mr-sandman-labs/flight-computer/README.md

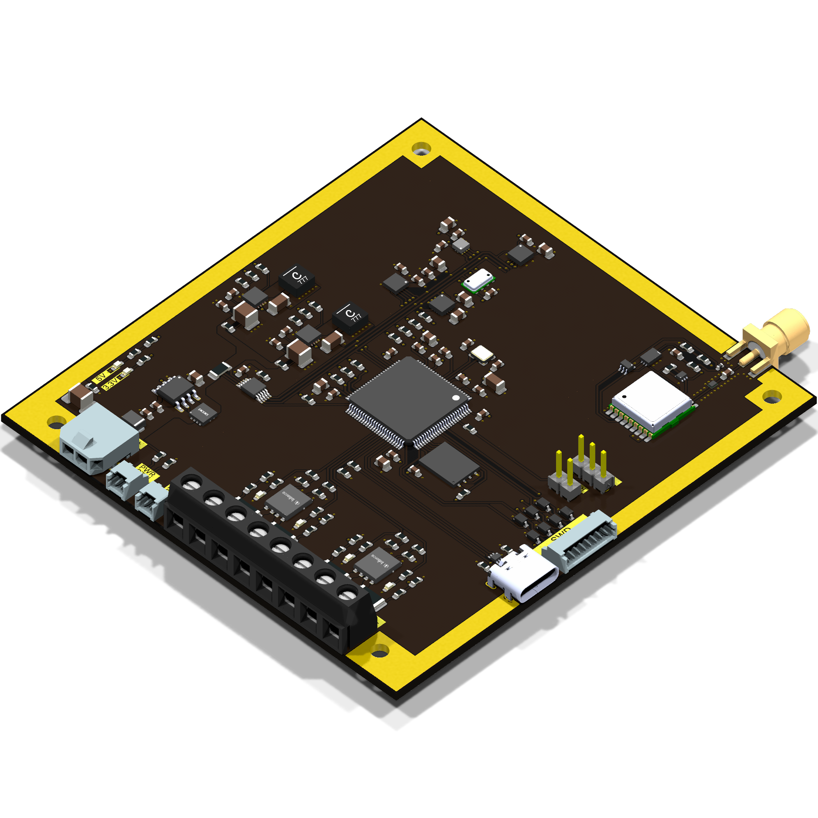
[picture p1: development/render/isometric_top.png]

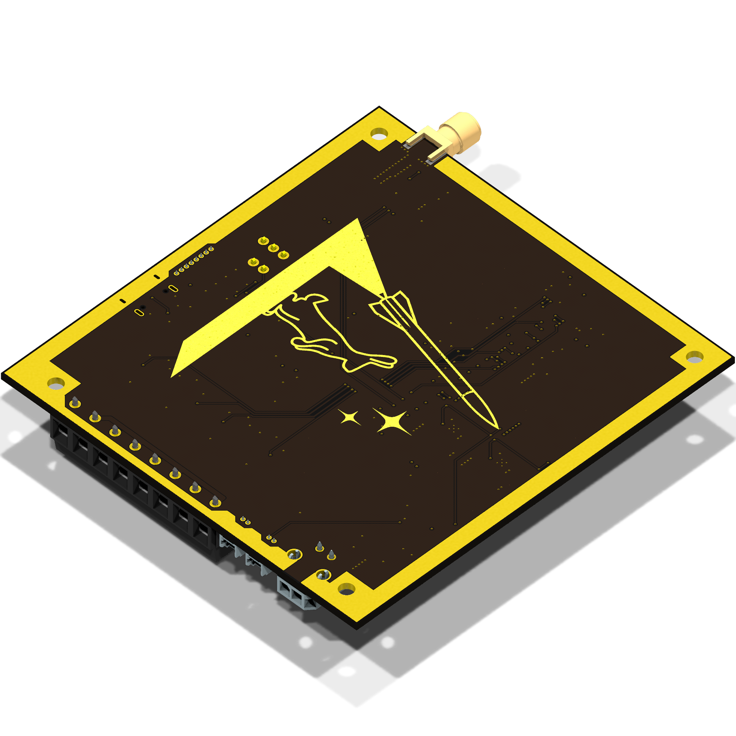
[picture p2: development/render/isometric_bottom.png]
