mr-sandman-labs/flight-computer/development/schematic.pdf

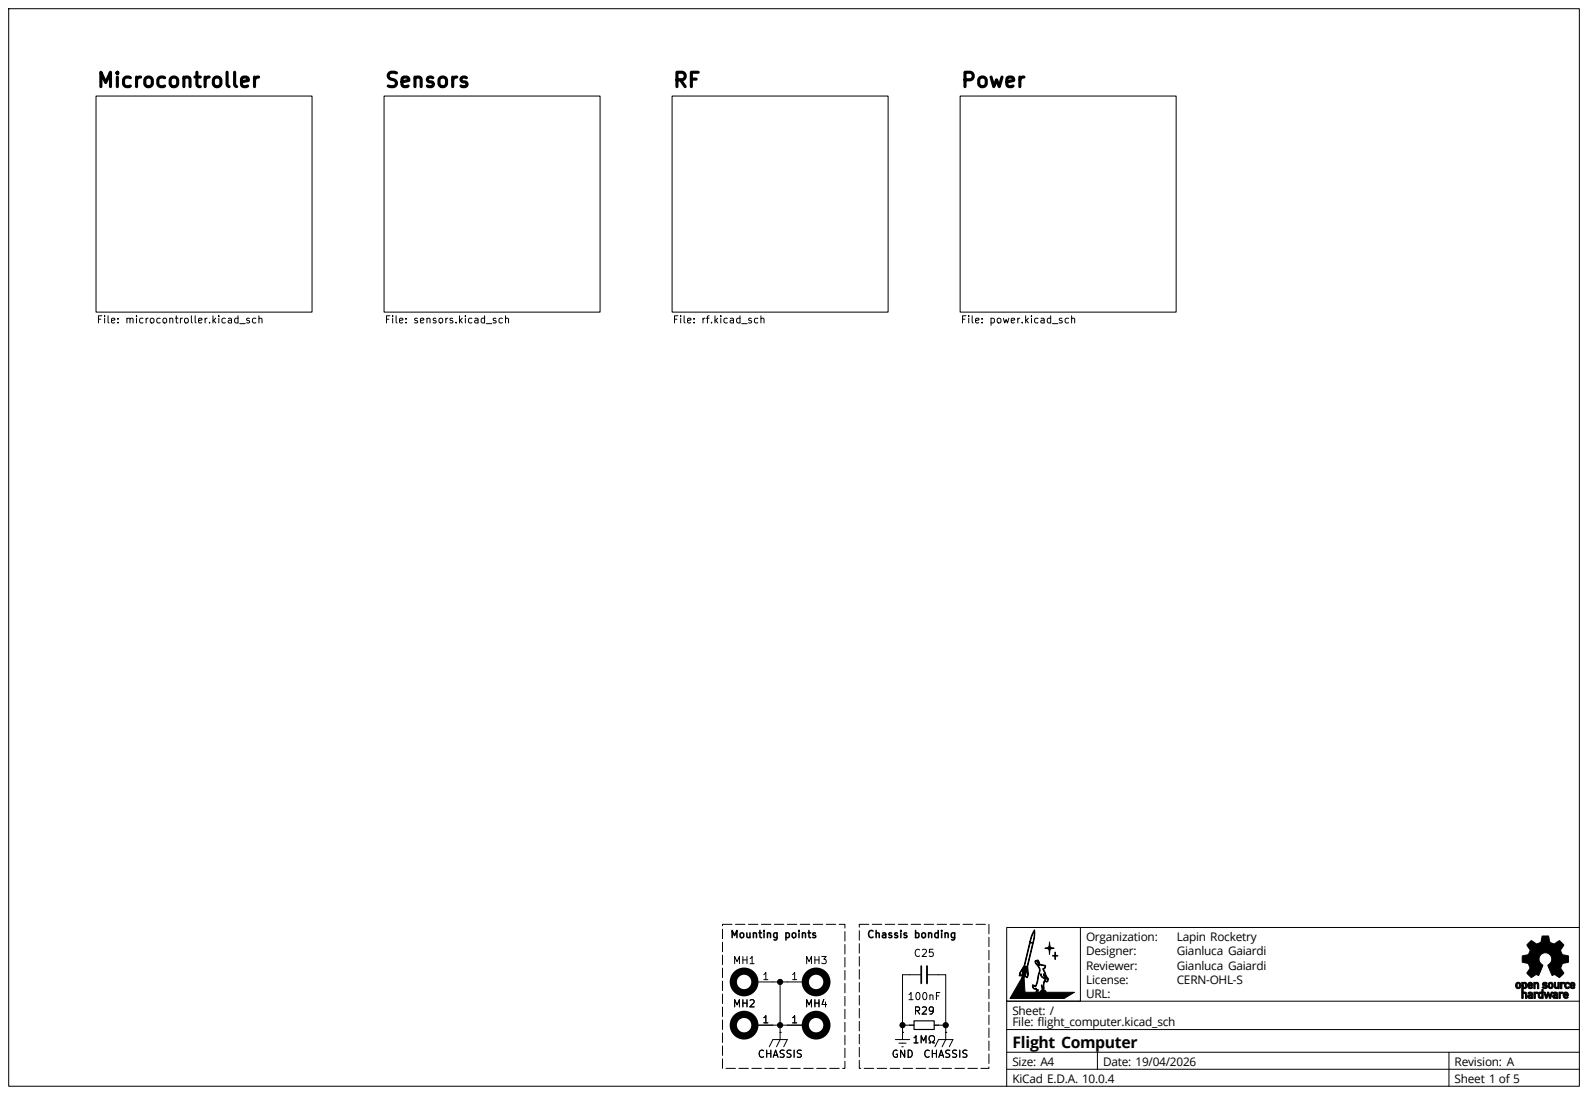
[picture p3: page 1]

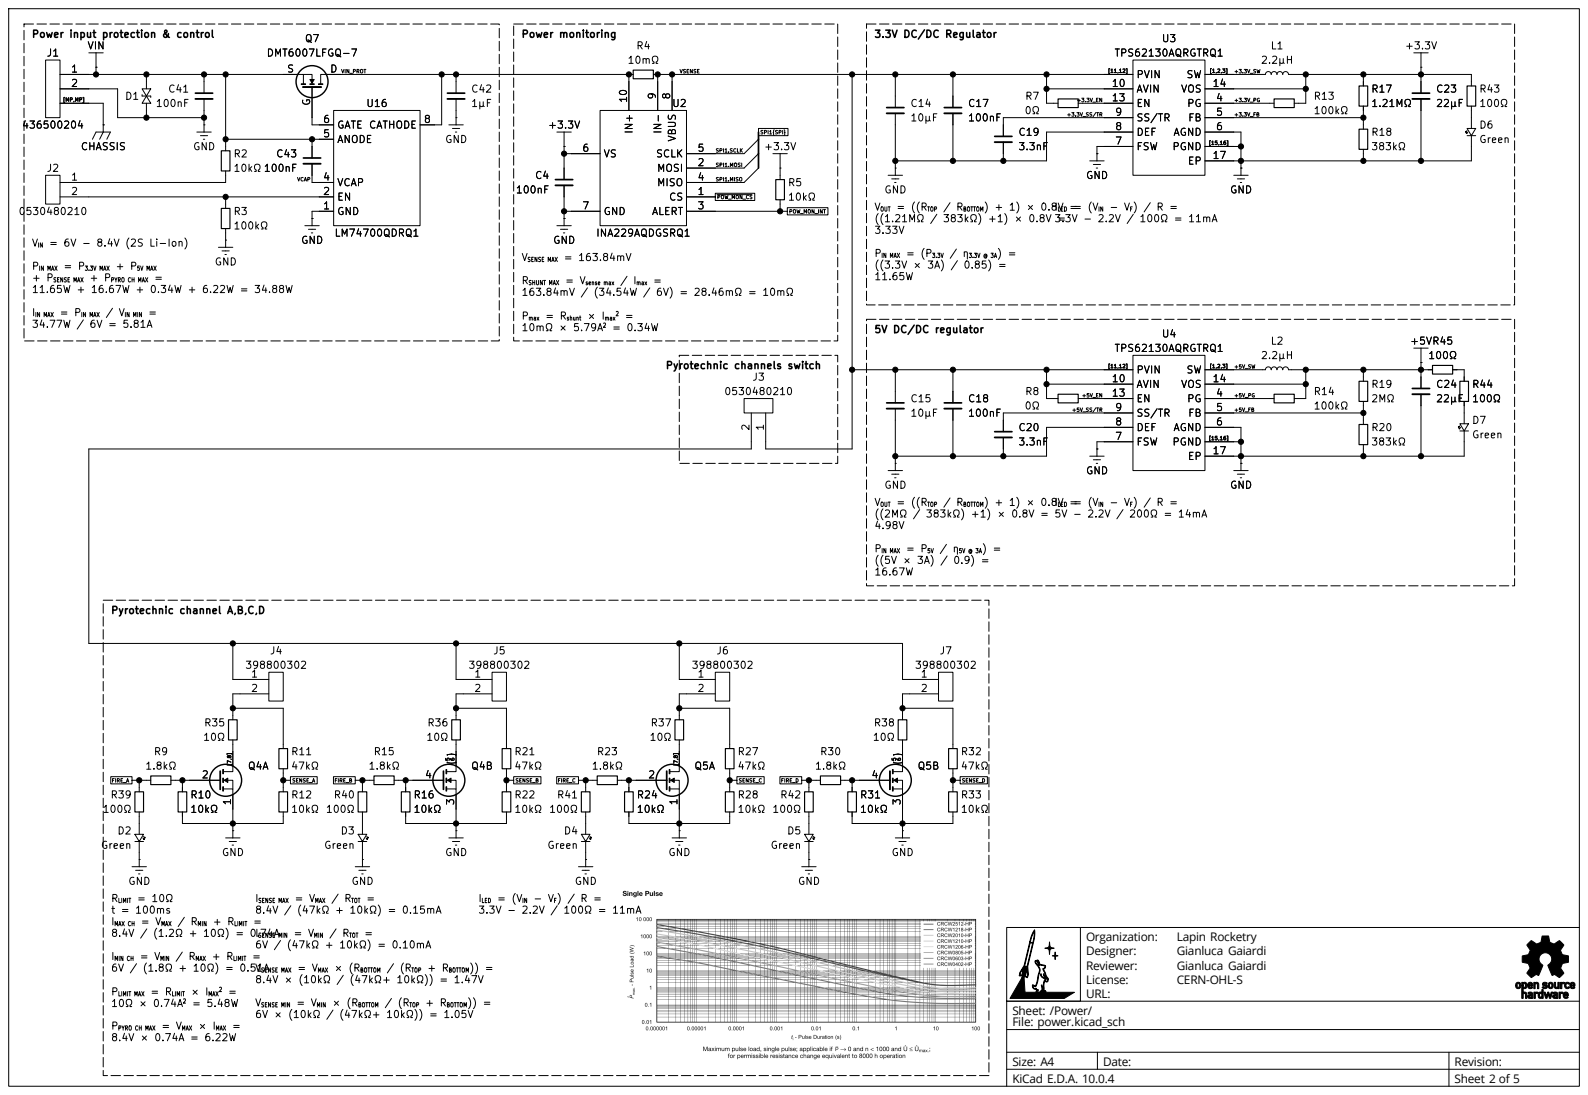
[picture p4: page 2]

VIN = 6V - 8.4V (2S Li-Ion) PIN MAX = P3.3V MAX + P5V MAX + PSENSE MAX + PPYRO CH MAX =

VSENSE MAX = 163.84mV RSHUNT MAX = Vsense max / Imax =

IIN MAX = PIN MAX / VIN MIN =

Pyrotechnic channels switch RLIMIT = 10Ω

ISENSE MAX = VMAX / RTOT =

ISENSE MIN = VMIN / RTOT =

IMIN CH = VMIN / RMAX + RLIMIT =
6V / (1.8Ω + 10Ω) = 0.51A PLIMIT MAX = RLIMIT × IMAX2 =

Sheet: /Power/URL: License: Reviewer: Designer:

VSENSE MAX = VMAX × (RBOTTOM / (RTOP + RBOTTOM)) =

VSENSE MIN = VMIN × (RBOTTOM / (RTOP + RBOTTOM)) =

PPYRO CH MAX = VMAX × IMAX =

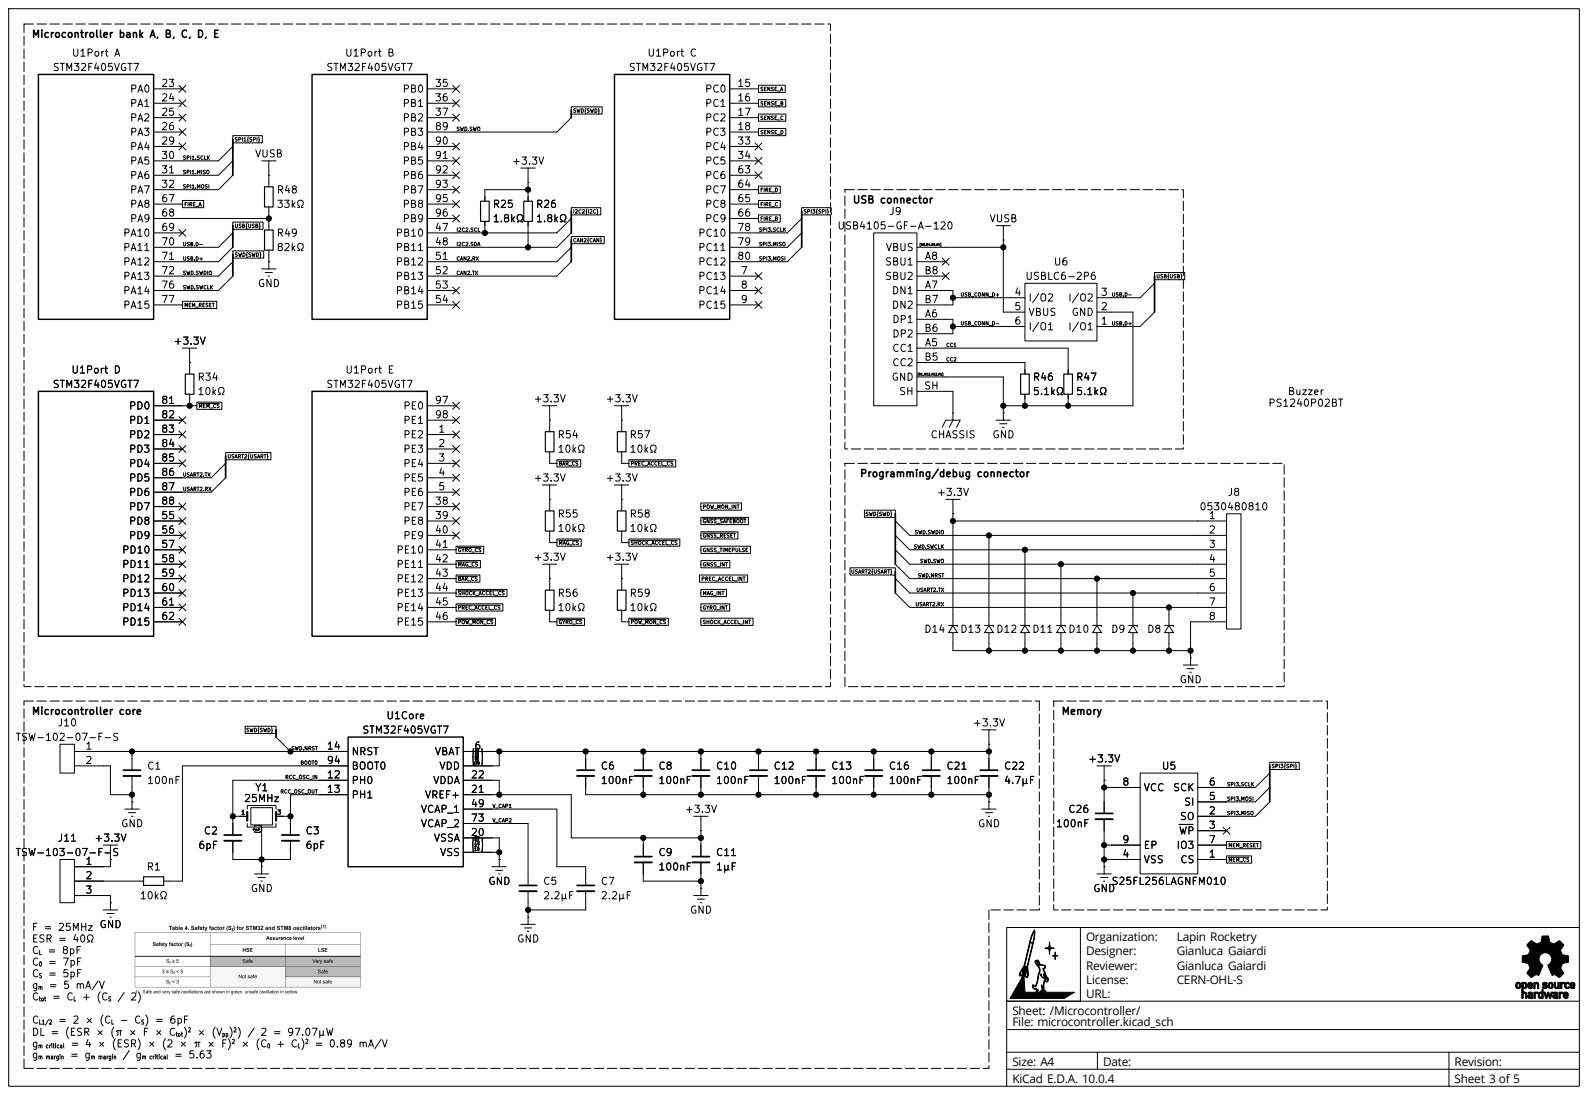
[picture p5: page 3]

Programming/debug connector F = 25MHz ESR = 40Ω

SWD.NRST SWD.SWDIO

2 = 0.89 mA/V gm margin = gm margin / gm critical = 5.63 Microcontroller core

CL = 8pF C0 = 7pF CS = 5pF gm = 5 mA/V Ctot = CL + (CS / 2) CL1/2 = 2 × (CL - CS) = 6pF DL = (ESR × (π × F × Ctot)

Sheet: /Microcontroller/ URL: License: Reviewer: Designer:

gm critical = 4 × (ESR) × (2 × π × F)2 × (C0 + CL)

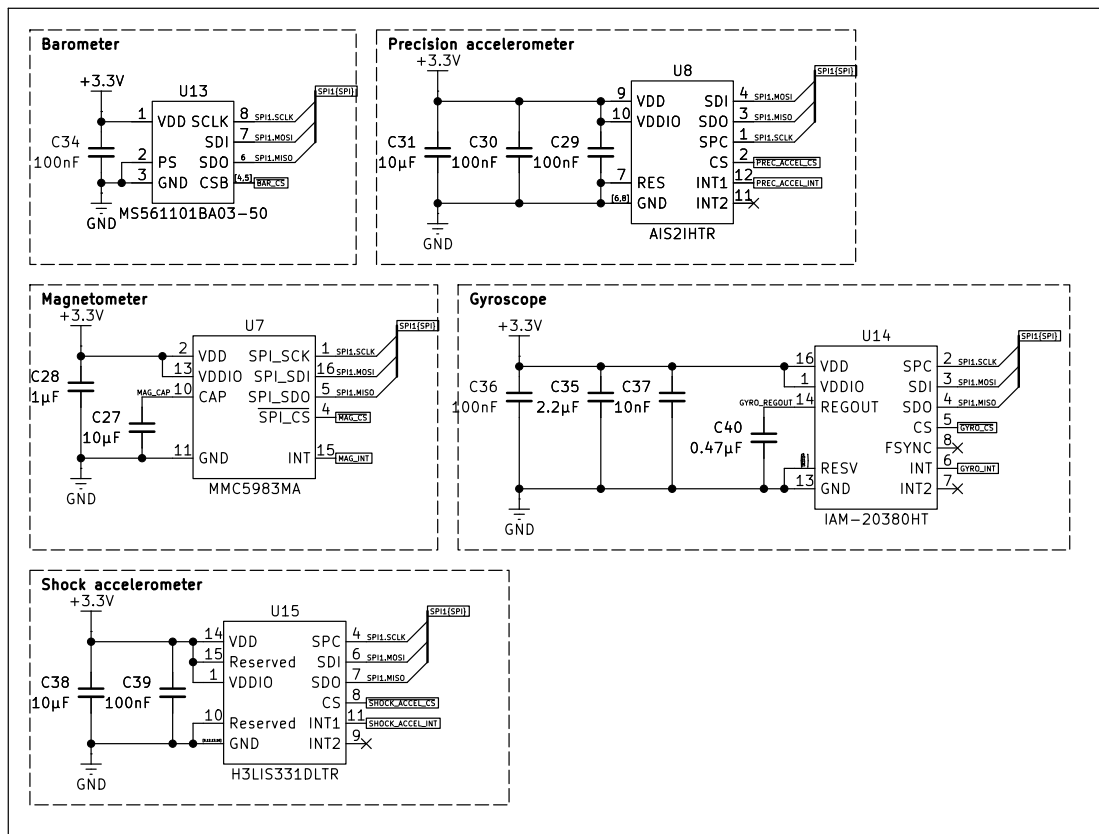
[picture p6: page 4]

Sheet: /Sensors/ URL: License: Reviewer: Designer:

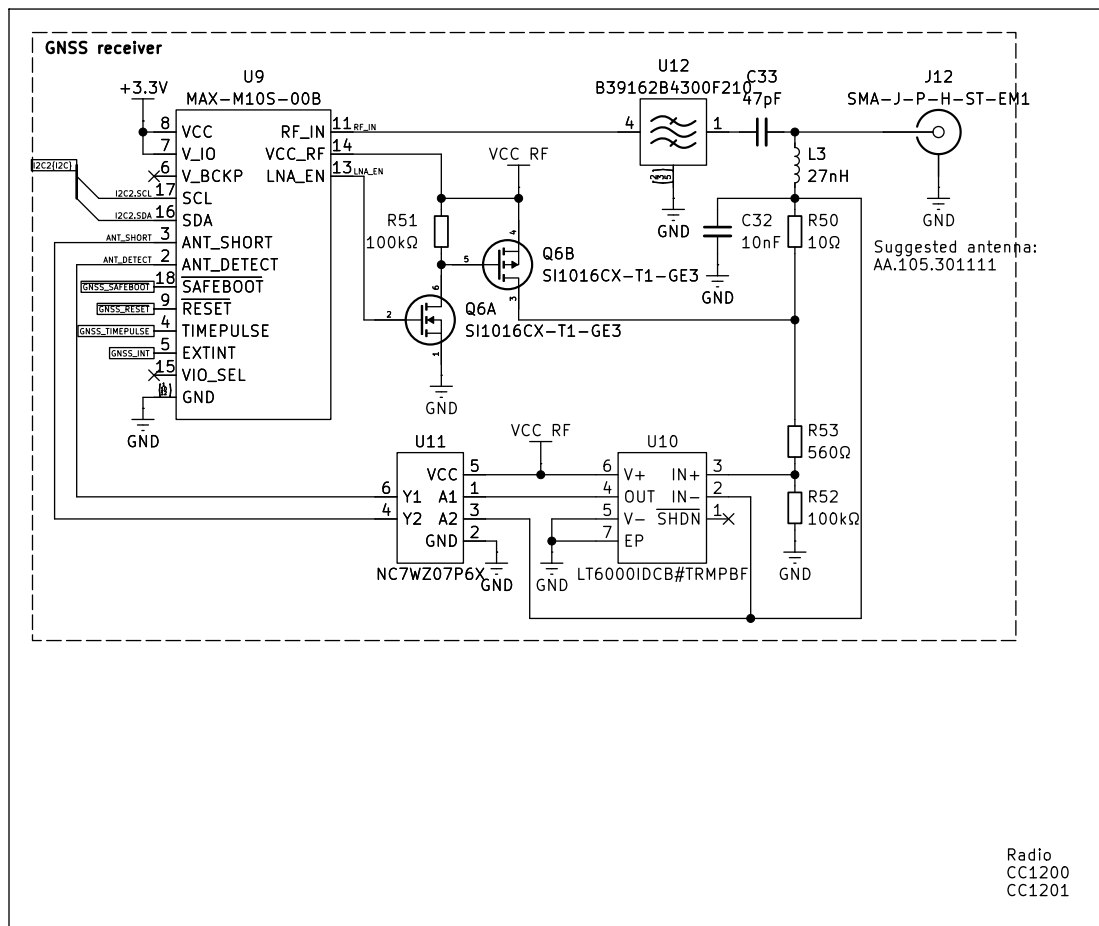
[picture p7: page 5]
