mr-sandman-labs/flight-computer/flight_computer.kicad_pcb

## KiCad design flight_computer.kicad_pcb (2026-06-22)

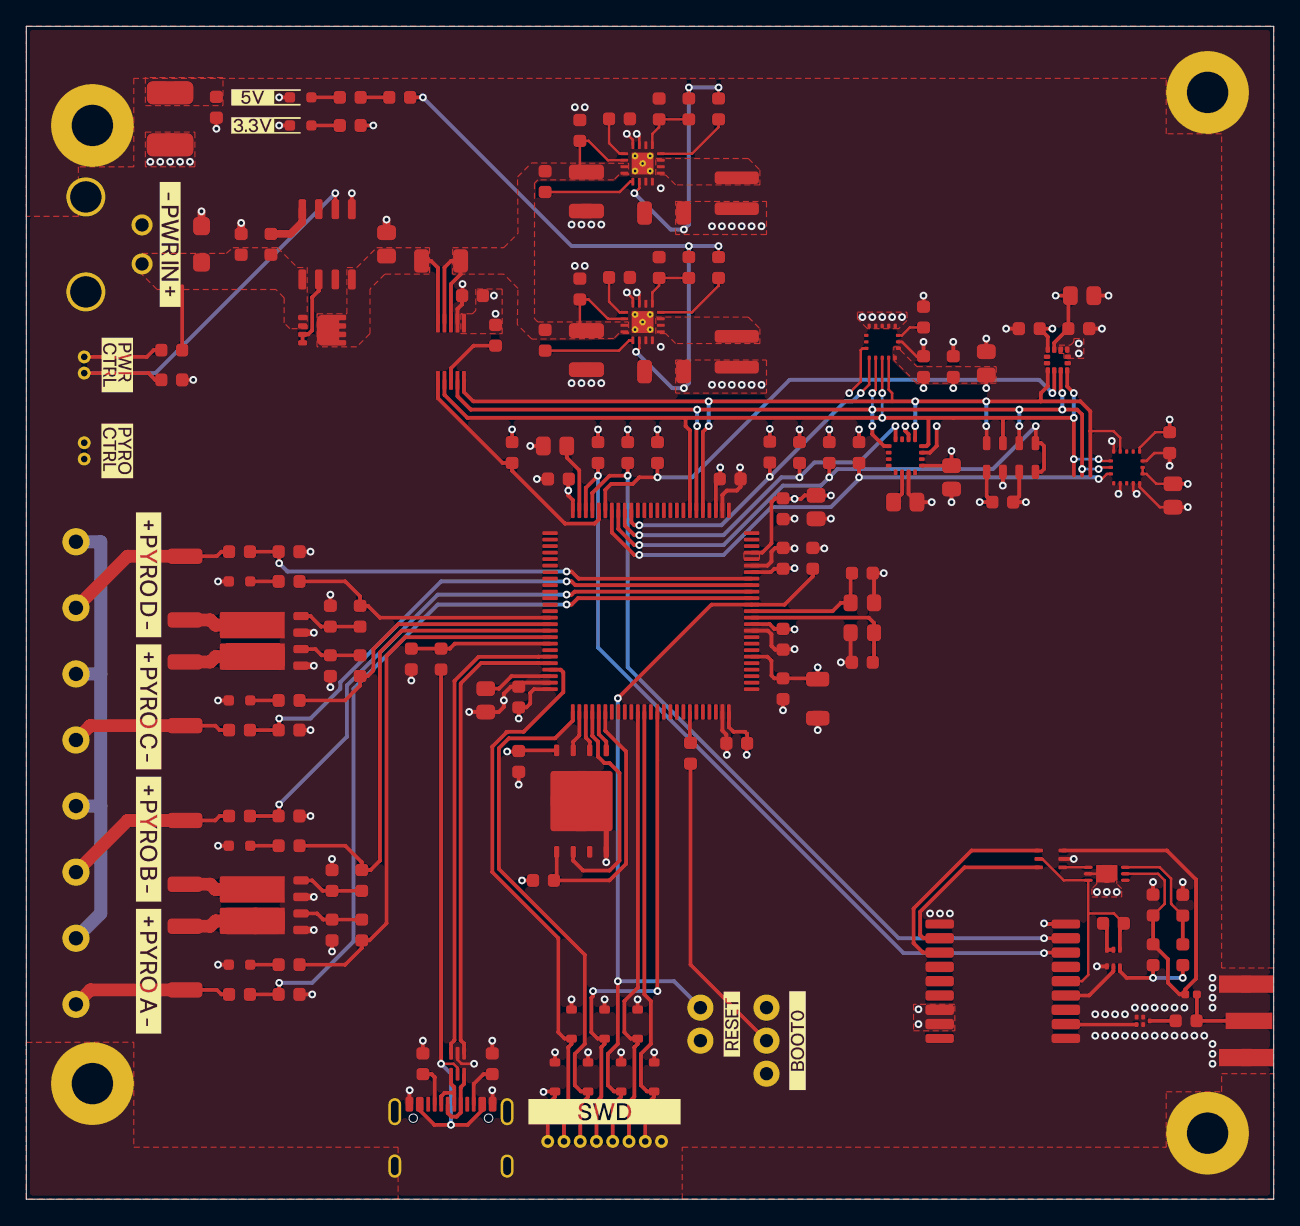
[picture p16: board flight_computer.kicad_pcb from above]

Board: 4 copper layers, 95.9 x 90.2 mm, 167 parts (0 on the bottom side), 100 nets.

Parts:
C1, C4, C6, C8, C9, C10, C12, C13, C16, C17, C18, C21, C26, C29, C30, C34, C36, C39, C41, C43: 100nF; C_0603_Density_Nominal
C2, C3: 6pF; C_0603_Density_Nominal
C5, C7, C35: 2.2μF; C_0805_Density_Nominal
C11, C28, C42: 1μF; C_0805_Density_Nominal
C14, C15: 10μF; C_1210_Density_Nominal
C19, C20: 3.3nF; C_0603_Density_Nominal
C22: 4.7μF; C_1206_Density_Nominal
C23, C24: 22μF; C_1206_Density_Nominal
C25: 100nF; C_1812_Density_Nominal
C27, C31, C38: 10μF; C_0805_Density_Nominal
C32, C37: 10nF; C_0603_Density_Nominal
C33: 47pF; C_0603_Density_Nominal
C40: 0.47µF; C_0603_Density_Nominal
D1: SZSMF4L17CAT3G
D2, D3, D4, D5, D6, D7: Green; SML-D12P8WT86C
D8, D9, D10, D11, D12, D13, D14: SZESD7351HT1G
J1: 436500204
J2, J3: 0530480210
J4, J5, J6, J7: 398800302
J8: 0530480810
J9: USB4105-GF-A-120
J10: TSW-102-07-F-S
J11: TSW-103-07-F-S
J12: SMA-J-P-H-ST-EM1
L1, L2: 2.2μH; XGL4020-222MEC
L3: 27nH; L_0402_Density_Nominal
MH1, MH2, MH3, MH4: M3
Q4, Q5: IPG20N04S4L08ATMA1
Q6: SI1016CX-T1-GE3
Q7: DMT6007LFGQ-7
R1, R2, R5, R10, R12, R16, R22, R24, R28, R31, R33, R34, R54, R55, R56, R57, R58, R59: 10kΩ; R_0603_Density_Nominal
R3, R13, R14, R51, R52: 100kΩ; R_0603_Density_Nominal
R4: 10mΩ; R_1206_Density_Nominal
R7, R8: 0Ω; R_0603_Density_Nominal
R9, R15, R23, R25, R26, R30: 1.8kΩ; R_0603_Density_Nominal
R11, R21, R27, R32: 47kΩ; R_0603_Density_Nominal
R17: 1.21MΩ; R_0603_Density_Nominal
R18, R20: 383kΩ; R_0603_Density_Nominal
R19: 2MΩ; R_0603_Density_Nominal
R29: 1MΩ; R_0603_Density_Nominal
R35, R36, R37, R38: 10Ω; R_2010_Density_Nominal
R39, R40, R41, R42, R43, R44, R45: 100Ω; R_0603_Density_Nominal
R46, R47: 5.1kΩ; R_0603_Density_Nominal
R48: 33kΩ; R_0603_Density_Nominal
R49: 82kΩ; R_0603_Density_Nominal
R50: 10Ω; R_0603_Density_Nominal
R53: 560Ω; R_0603_Density_Nominal
U1: STM32F405VGT7
U2: INA229AQDGSRQ1
U3, U4: TPS62130AQRGTRQ1
U5: S25FL256LAGNFM010
U6: USBLC6-2P6
U7: MMC5983MA
U8: AIS2IHTR
U9: MAX-M10S-00B
U10: LT6000IDCB#TRMPBF
U11: NC7WZ07P6X
U12: B39162B4300F210
U13: MS561101BA03-50
U14: IAM-20380HT
U15: H3LIS331DLTR
U16: LM74700QDRQ1
Y1: 25MHz; ECS-250-8-33Q-RES-TR
kibuzzard-6A2D8A19: G***; kibuzzard-6A2D8A19
kibuzzard-6A2D86D8: G***; kibuzzard-6A2D86D8
kibuzzard-6A2D86DB: G***; kibuzzard-6A2D86DB
kibuzzard-6A2D88AE: G***; kibuzzard-6A2D88AE
kibuzzard-6A2D88CA: G***; kibuzzard-6A2D88CA
kibuzzard-6A2D88D0: G***; kibuzzard-6A2D88D0
kibuzzard-6A2D88D5: G***; kibuzzard-6A2D88D5
kibuzzard-6A2D89E8: G***; kibuzzard-6A2D89E8
kibuzzard-6A2D888E: G***; kibuzzard-6A2D888E
kibuzzard-6A2D8804: G***; kibuzzard-6A2D8804
kibuzzard-6A2D8820: G***; kibuzzard-6A2D8820
kibuzzard-6A2DBB13: G***; kibuzzard-6A2DBB13

Connections:
+3.3V: C4.1, C6.1, C8.1, C9.1, C10.1, C11.1, C12.1, C13.1, C16.1, C21.1, C22.1, C23.1, C26.1, C28.1, C29.1, C30.1, C31.1, C34.1, C35.1, C36.1, C37.1, C38.1, C39.1, D14.1, J8.1, J11.1, L1.2, R5.1, R13.2, R17.1, R25.1, R26.1, R34.1, R43.1, R54.1, R55.1, R56.1, R57.1, R58.1, R59.1, U1.6 (VBAT), U1.11 (VDD), U1.19 (VDD), U1.21 (VREF+), U1.22 (VDDA), U1.28 (VDD), U1.50 (VDD), U1.75 (VDD), U1.100 (VDD), U2.6 (VS), U3.14 (VOS), U5.8 (VCC), U7.2 (VDD), U7.13 (VDDIO), U8.9 (VDD), U8.10 (VDDIO), U9.7 (V_IO), U9.8 (VCC), U13.1 (VDD), U14.1 (VDDIO), U14.16 (VDD), U15.1 (VDDIO), U15.14 (VDD), U15.15 (Reserved)
+5V: C24.1, L2.2, R14.2, R19.1, R45.1, U4.14 (VOS)
/Microcontroller/BOOT0: R1.2, U1.94 (BOOT0)
/Microcontroller/CC1: J9.A5 (CC1), R47.1
/Microcontroller/CC2: J9.B5 (CC2), R46.1
/Microcontroller/RCC_OSC_IN: C2.1, U1.12 (PH0), Y1.1
/Microcontroller/RCC_OSC_OUT: C3.1, U1.13 (PH1), Y1.3
/Microcontroller/USB_CONN_D+: J9.A7 (DN1), J9.B7 (DN2), U6.4 (I/O2)
/Microcontroller/USB_CONN_D-: J9.A6 (DP1), J9.B6 (DP2), U6.6 (I/O1)
/Microcontroller/V_CAP1: C7.1, U1.49 (VCAP_1)
/Microcontroller/V_CAP2: C5.1, U1.73 (VCAP_2)
/Power/+3.3V_EN: R7.2, U3.13 (EN)
/Power/+3.3V_FB: R17.2, R18.1, U3.5 (FB)
/Power/+3.3V_PG: R13.1, U3.4 (PG)
/Power/+3.3V_SS/TR: C19.1, U3.9 (SS/TR)
/Power/+3.3V_SW: L1.1, U3.1 (SW), U3.2 (SW), U3.3 (SW)
/Power/+5V_EN: R8.2, U4.13 (EN)
/Power/+5V_FB: R19.2, R20.1, U4.5 (FB)
/Power/+5V_PG: R14.1, U4.4 (PG)
/Power/+5V_SS/TR: C20.1, U4.9 (SS/TR)
/Power/+5V_SW: L2.1, U4.1 (SW), U4.2 (SW), U4.3 (SW)
/Power/VCAP: C43.2, U16.4 (VCAP)
/Power/VIN_PROT: C42.1, Q7.D, R4.1, U2.10 (IN+), U16.8 (CATHODE)
/Power/VSENSE: C14.1, C15.1, C17.1, C18.1, J3.1, R4.2, R7.1, R8.1, U2.8 (VBUS), U2.9 (IN-), U3.10 (AVIN), U3.11 (PVIN), U3.12 (PVIN), U4.10 (AVIN), U4.11 (PVIN), U4.12 (PVIN)
/RF/ANT_DETECT: U9.2 (ANT_DETECT), U11.6 (Y1)
/RF/ANT_SHORT: U9.3 (ANT_SHORT), U11.4 (Y2)
/RF/LNA_EN: Q6.2 (G), U9.13 (LNA_EN)
/RF/RF_IN: U9.11 (RF_IN), U12.4 (Output)
/Sensors/GYRO_REGOUT: C40.1, U14.14 (REGOUT)
/Sensors/MAG_CAP: C27.1, U7.10 (CAP)
CHASSIS: C25.2, J1.MP, J9.SH, MH1.1 (MH_1), MH2.1 (MH_1), MH3.1 (MH_1), MH4.1 (MH_1), R29.2
FIRE_A: R9.1, R39.1, U1.67 (PA8)
FIRE_B: R15.1, R40.1, U1.66 (PC9)
FIRE_C: R23.1, R41.1, U1.65 (PC8)
FIRE_D: R30.1, R42.1, U1.64 (PC7)
GND: C1.2, C2.2, C3.2, C4.2, C5.2, C6.2, C7.2, C8.2, C9.2, C10.2, C11.2, C12.2, C13.2, C14.2, C15.2, C16.2, C17.2, C18.2, C19.2, C20.2, C21.2, C22.2, C23.2, C24.2, C25.1, C26.2, C27.2, C28.2, C29.2, C30.2, C31.2, C32.2, C34.2, C35.2, C36.2, C37.2, C38.2, C39.2, C40.2, C41.2, C42.2, D1.2, D2.1, D3.1, D4.1, D5.1, D6.1, D7.1, D8.2, D9.2, D10.2, D11.2, D12.2, D13.2, D14.2, J1.2, J8.8, J9.A1 (GND), J9.A12 (GND), J9.B1 (GND), J9.B12 (GND), J10.2, J11.3, J12.2, Q4.1 (S), Q4.3 (S), Q5.1 (S), Q5.3 (S), Q6.1 (S), R3.2, R10.2, R12.2, R16.2, R18.2, R20.2, R22.2, R24.2, R28.2, R29.1, R31.2, R33.2, R46.2, R47.2, R49.2, R52.2, U1.10 (VSS), U1.20 (VSSA), U1.27 (VSS), U1.74 (VSS), U1.99 (VSS), U2.7 (GND), U3.6 (AGND), U3.7 (FSW), U3.8 (DEF), U3.15 (PGND), U3.16 (PGND), U3.17 (EP), U4.6 (AGND), U4.7 (FSW), U4.8 (DEF), U4.15 (PGND), U4.16 (PGND), U4.17 (EP), U5.4 (VSS), U5.9 (EP), U6.2 (GND), U7.11 (GND), U8.6 (GND), U8.7 (RES), U8.8 (GND), U9.1 (GND), U9.10 (GND), U9.12 (GND), U10.5 (V-), U10.7 (EP), U11.2 (GND), U12.2 (GND), U12.3 (GND), U12.5 (GND), U13.2 (PS), U13.3 (GND), U14.9 (RESV), U14.10 (RESV), U14.11 (RESV), U14.12 (RESV), U14.13 (GND), U14.15 (RESV), U15.5 (GND), U15.10 (Reserved), U15.12 (GND), U15.13 (GND), U15.16 (GND), U16.1 (GND), Y1.2 (GND), Y1.4 (GND)
I2C2.SCL: R25.2, U1.47 (PB10), U9.17 (SCL)
I2C2.SDA: R26.2, U1.48 (PB11), U9.16 (SDA)
MEM_RESET: U1.77 (PA15), U5.7 (IO3)
unnamed: C33.2, J12.1, L3.1
unnamed: D2.2, R39.2
unnamed: D3.2, R40.2
unnamed: D4.2, R41.2
unnamed: D5.2, R42.2
unnamed: D6.2, R43.2
unnamed: D7.2, R44.2
unnamed: J2.1, R2.2
unnamed: J3.2, J4.1, J5.1, J6.1, J7.1
unnamed: J4.2, R11.1, R35.1
unnamed: J5.2, R21.1, R36.1
unnamed: J6.2, R27.1, R37.1
unnamed: J7.2, R32.1, R38.1
unnamed: J11.2, R1.1
unnamed: Q4.7 (D), Q4.8 (D), R35.2
unnamed: Q4.2 (G), R9.2, R10.1
unnamed: Q4.5 (D), Q4.6 (D), R36.2
unnamed: Q4.4 (G), R15.2, R16.1
unnamed: Q5.7 (D), Q5.8 (D), R37.2
unnamed: Q5.2 (G), R23.2, R24.1
unnamed: Q5.5 (D), Q5.6 (D), R38.2
unnamed: Q5.4 (G), R30.2, R31.1
unnamed: Q6.5 (G), Q6.6 (D), R51.1
unnamed: Q6.3 (D), R50.2, R53.1
unnamed: R44.1, R45.2
unnamed: R48.2, R49.1, U1.68 (PA9)
unnamed: R52.1, R53.2, U10.3 (IN+)
unnamed: C32.1, L3.2, R50.1, U10.2 (IN-), U11.3 (A2)
unnamed: U10.4 (OUT), U11.1 (A1)
unnamed: C33.1, U12.1 (Input)
unnamed: J2.2, R3.1, U16.2 (EN)
unnamed: Q7.G, U16.6 (GATE)
POW_MON_INT: R5.2, U2.3 (ALERT)
SENSE_A: R11.2, R12.1, U1.15 (PC0)
SENSE_B: R21.2, R22.1, U1.16 (PC1)
SENSE_C: R27.2, R28.1, U1.17 (PC2)
SENSE_D: R32.2, R33.1, U1.18 (PC3)
SPI1.MISO: U1.31 (PA6), U2.4 (MISO), U7.5 (SPI_SDO), U8.3 (SDO), U13.6 (SDO), U14.4 (SDO), U15.7 (SDO)
SPI1.MOSI: U1.32 (PA7), U2.2 (MOSI), U7.16 (SPI_SDI), U8.4 (SDI), U13.7 (SDI), U14.3 (SDI), U15.6 (SDI)
SPI1.SCLK: U1.30 (PA5), U2.5 (SCLK), U7.1 (SPI_SCK), U8.1 (SPC), U13.8 (SCLK), U14.2 (SPC), U15.4 (SPC)
SPI3.MISO: U1.79 (PC11), U5.2 (SO)
SPI3.MOSI: U1.80 (PC12), U5.5 (SI)
SPI3.SCLK: U1.78 (PC10), U5.6 (SCK)
SWD.NRST: C1.1, D10.1, J8.5, J10.1, U1.14 (NRST)
SWD.SWCLK: D12.1, J8.3, U1.76 (PA14)
SWD.SWDIO: D13.1, J8.2, U1.72 (PA13)
SWD.SWO: D11.1, J8.4, U1.89 (PB3)
USART2.RX: D8.1, J8.7, U1.87 (PD6)
USART2.TX: D9.1, J8.6, U1.86 (PD5)
USB.D+: U1.71 (PA12), U6.1 (I/O1)
USB.D-: U1.70 (PA11), U6.3 (I/O2)
VCC RF: Q6.4 (S), R51.2, U9.14 (VCC_RF), U10.6 (V+), U11.5 (VCC)
VIN: C41.1, C43.1, D1.1, J1.1, Q7.S, R2.1, U16.5 (ANODE)
VUSB: J9.A4 (VBUS), J9.A9 (VBUS), J9.B4 (VBUS), J9.B9 (VBUS), R48.1, U6.5 (VBUS)
~BAR_CS: R54.2, U1.43 (PE12), U13.4 (CSB), U13.5 (CSB)
~GYRO_CS: R56.2, U1.41 (PE10), U14.5 (CS)
~MAG_CS: R55.2, U1.42 (PE11), U7.4 (~SPI_CS)
~MEM_CS: R34.2, U1.81 (PD0), U5.1 (CS)
~POW_MON_CS: R59.2, U1.46 (PE15), U2.1 (CS)
~PREC_ACCEL_CS: R57.2, U1.45 (PE14), U8.2 (CS)
~SHOCK_ACCEL_CS: R58.2, U1.44 (PE13), U15.8 (CS)
