mr-sandman-labs/flight-computer/(commit log)

2026-06-13 Update workflows to KiCAD 10.0
2026-06-13 Update board images
2026-06-13 Update to power section
    [flight_computer.kicad_pcb, power.kicad_sch]
2026-06-13 Update board images [88bcb92]
2026-06-13 Move component to test workflows
    [flight_computer.kicad_pcb]
2026-06-13 Update board images [8ed35ce]
2026-06-13 Add README
    [flight_computer.kicad_pcb]
2026-06-13 Update board images [75ed3b0]
2026-06-14 Add initial layout for the GNSS receiver
    [flight_computer.kicad_pcb, rf.kicad_sch]
2026-06-14 Update board images [02bf611]
2026-06-14 Improve board grounding for RF
    [flight_computer.kicad_pcb, rf.kicad_sch]
2026-06-14 Update board images [301fe3e]
2026-06-14 Fix copper pour rule inconsistencies
    [flight_computer.kicad_pcb]
2026-06-14 Update board images [851bdfc]
2026-06-14 - On push in main create a new set of documents - On release fix images - Update README to use correct images
    [flight_computer.kicad_pcb, mcu.kicad_sch]
2026-06-14 Update board images [dbde93b]
    [flight_computer-B_Cu.gbl, flight_computer-B_Mask.gbs, flight_computer-B_Paste.gbp, flight_computer-B_Silkscreen.gbo, flight_computer-Edge_Cuts.gm1, flight_computer-F_Cu.gtl, flight_computer-F_Mask.gts, flight_computer-F_Paste.gtp]
2026-06-15 Major fix: move from a flat to a hierarchical architecture for schematic.
    [flight_computer.kicad_pcb, flight_computer.kicad_sch, mcu.kicad_sch, microcontroller.kicad_sch, power.kicad_sch, rf.kicad_sch, sensors.kicad_sch]
2026-06-15 Update board images [f69413a]
    [flight_computer-B_Cu.gbl, flight_computer-B_Mask.gbs, flight_computer-B_Paste.gbp, flight_computer-B_Silkscreen.gbo, flight_computer-Edge_Cuts.gm1, flight_computer-F_Cu.gtl, flight_computer-F_Mask.gts, flight_computer-F_Paste.gtp]
2026-06-15 Update workflows to use wLight for schematic export
2026-06-15 Update board images [9bae6d3]
    [flight_computer-B_Cu.gbl, flight_computer-B_Mask.gbs, flight_computer-B_Paste.gbp, flight_computer-B_Silkscreen.gbo, flight_computer-Edge_Cuts.gm1, flight_computer-F_Cu.gtl, flight_computer-F_Mask.gts, flight_computer-F_Paste.gtp]
2026-06-15 Update board images [fabf8d3]
    [flight_computer-B_Cu.gbl, flight_computer-B_Mask.gbs, flight_computer-B_Paste.gbp, flight_computer-B_Silkscreen.gbo, flight_computer-Edge_Cuts.gm1, flight_computer-F_Cu.gtl, flight_computer-F_Mask.gts, flight_computer-F_Paste.gtp]
2026-06-15 Update board images [a5016d6]
    [flight_computer-B_Cu.gbl, flight_computer-B_Mask.gbs, flight_computer-B_Paste.gbp, flight_computer-B_Silkscreen.gbo, flight_computer-Edge_Cuts.gm1, flight_computer-F_Cu.gtl, flight_computer-F_Mask.gts, flight_computer-F_Paste.gtp]
2026-06-15 Added measurements to PCB view
    [flight_computer.kicad_pcb]
2026-06-15 Update board images [e3fdb58]
    [flight_computer-B_Cu.gbl, flight_computer-B_Mask.gbs, flight_computer-B_Paste.gbp, flight_computer-B_Silkscreen.gbo, flight_computer-Edge_Cuts.gm1, flight_computer-F_Cu.gtl, flight_computer-F_Mask.gts, flight_computer-F_Paste.gtp]
2026-06-16 Improve PCB measurements
    [flight_computer.kicad_pcb]
2026-06-16 Update dependencies to fix AT-SPI error, embed fonts in project
    [flight_computer.kicad_pcb]
2026-06-16 Update board images [a53ee89]
    [flight_computer-B_Cu.gbl, flight_computer-B_Mask.gbs, flight_computer-B_Paste.gbp, flight_computer-B_Silkscreen.gbo, flight_computer-Edge_Cuts.gm1, flight_computer-F_Cu.gtl, flight_computer-F_Mask.gts, flight_computer-F_Paste.gtp]
2026-06-21 Moved GNSS to bottom right of the board, added sensor ro SPI bus, improved chassis ring to cover more parts of the board
    [flight_computer.kicad_pcb]
2026-06-21 Update board images [803d3a7]
    [flight_computer-B_Cu.gbl, flight_computer-B_Mask.gbs, flight_computer-B_Paste.gbp, flight_computer-B_Silkscreen.gbo, flight_computer-Edge_Cuts.gm1, flight_computer-F_Cu.gtl, flight_computer-F_Mask.gts, flight_computer-F_Paste.gtp]
2026-06-21 Added M3 mounting holes to schematic, replaced them in PCB layout so they appear in the output documents
    [flight_computer.kicad_pcb, flight_computer.kicad_sch, power.kicad_sch, rf.kicad_sch]
2026-06-21 Update board images [ad04d1f]
    [flight_computer-B_Cu.gbl, flight_computer-B_Mask.gbs, flight_computer-B_Paste.gbp, flight_computer-B_Silkscreen.gbo, flight_computer-Edge_Cuts.gm1, flight_computer-F_Cu.gtl, flight_computer-F_Mask.gts, flight_computer-F_Paste.gtp]
2026-06-22 Change mounting hole connection type to solid
    [flight_computer.kicad_pcb]
2026-06-22 Place pullup resistors for SPI bus
    [flight_computer.kicad_pcb, microcontroller.kicad_sch]
2026-06-22 Update board images [289f2f0]
    [flight_computer-B_Cu.gbl, flight_computer-B_Mask.gbs, flight_computer-B_Paste.gbp, flight_computer-B_Silkscreen.gbo, flight_computer-Edge_Cuts.gm1, flight_computer-F_Cu.gtl, flight_computer-F_Mask.gts, flight_computer-F_Paste.gtp]
