mr-sandman-labs/flight-computer/(notices)

Notices in the files:
parts and their libraries:
LICENSE: CERN-OHL-S
